SamuelLost/sbesc-esc-2024/README.md

# Boia para Monitoramento e Prevenção de Inundações - ESC 2024
