SamuelLost/sbesc-esc-2024/imgs/sbesc-water-level-v2.png

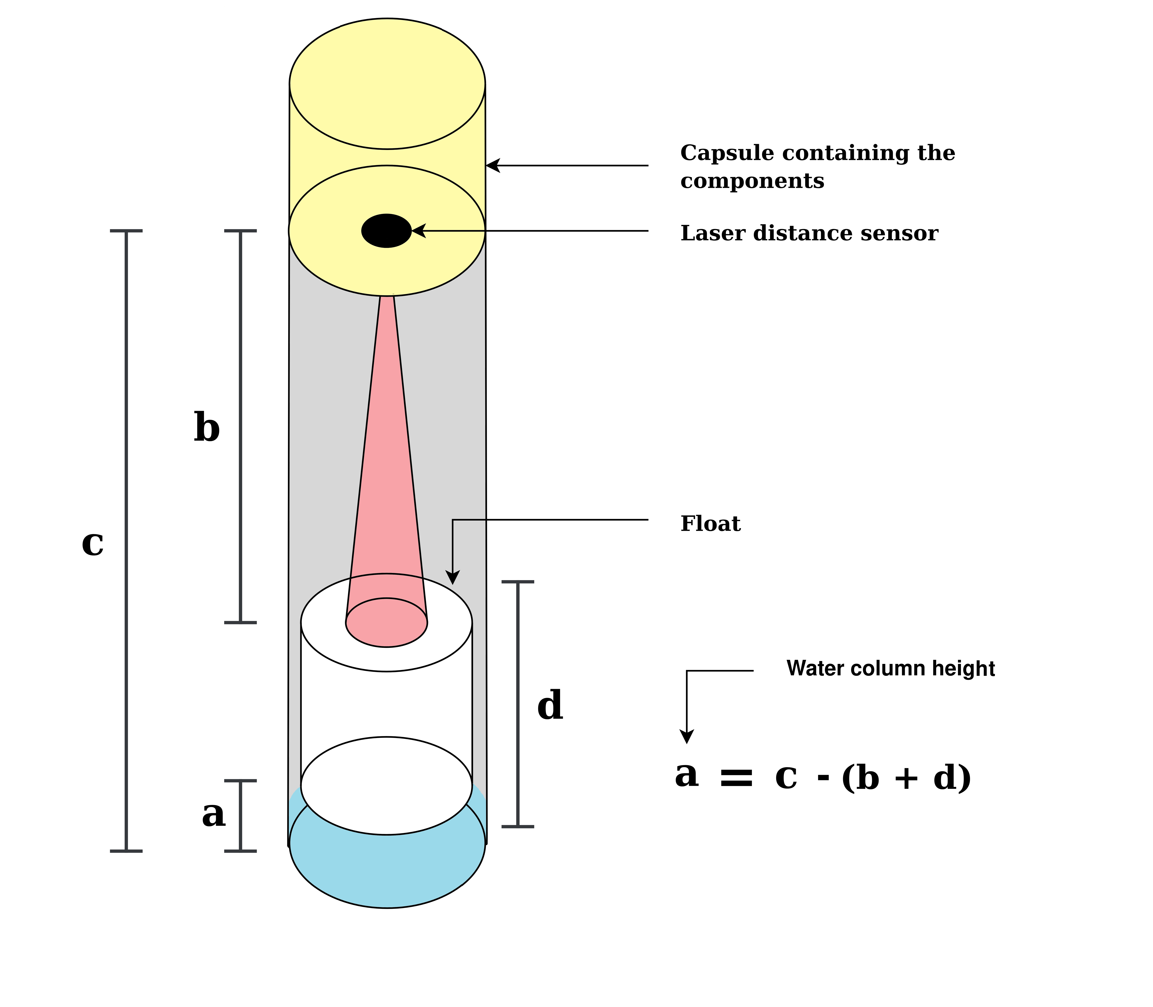
imgs/sbesc-water-level-v2.png
