SamuelLost/sbesc-esc-2024/imgs/sbesc-water-level.png

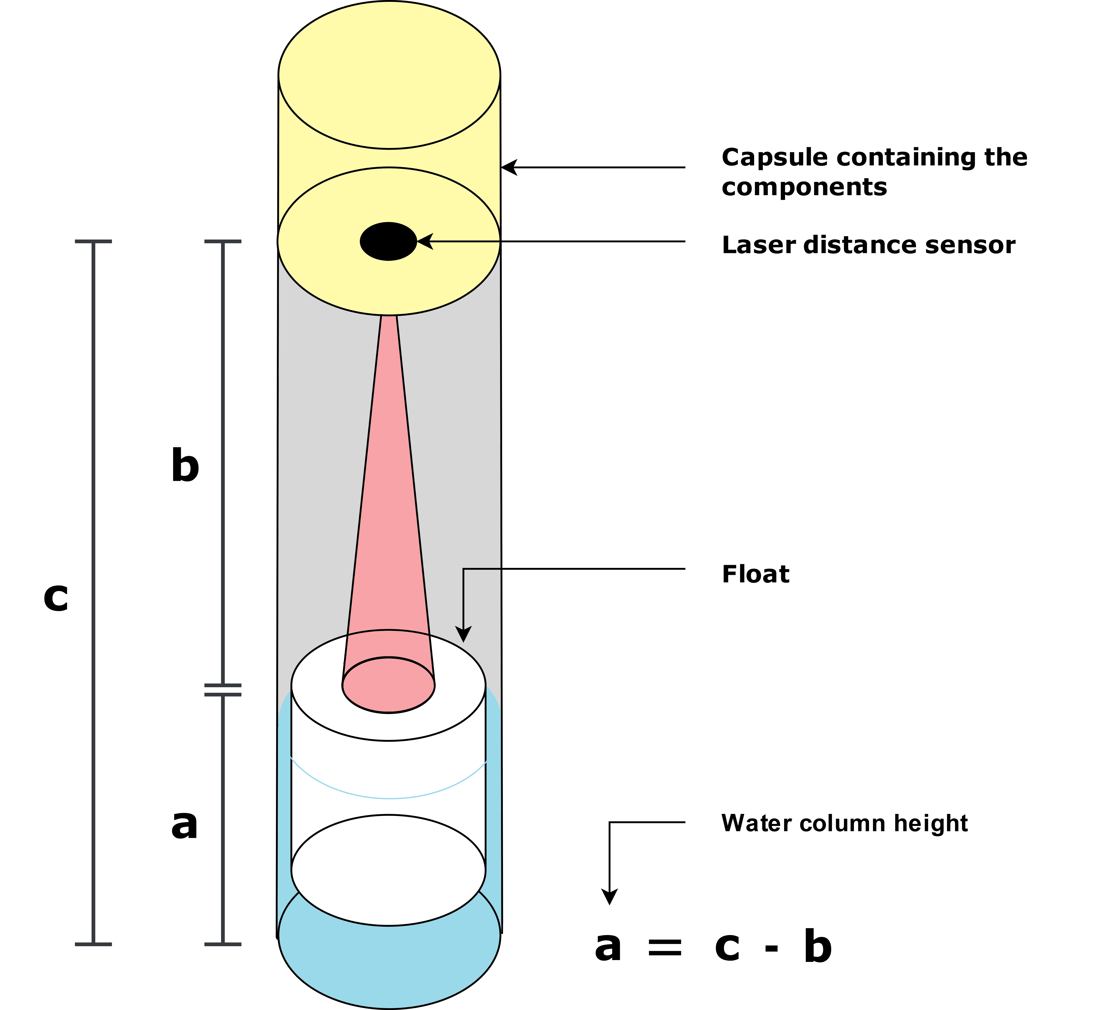
imgs/sbesc-water-level.png
