SamuelLost/sbesc-esc-2024/(list of files, drawings)

Other design files:
docs/fritzing/circuito_prototipo.fzz
docs/fritzing/circuito_prototipo_powerbank.fzz
docs/fritzing/node_receiver.fzz
