SamuelLost/sbesc-esc-2024/firmware/components/accelerometer_sensor/include/mpu6050.h

#ifndef _ACCELEROMETER_SENSOR_H_
#define _ACCELEROMETER_SENSOR_H_

#include <stdint.h>
#include <stdbool.h>
#include "esp_err.h"
#include "driver/i2c.h"
#include "i2c_driver.h"
#include "mpu6050_registers.h"


#ifdef __cplusplus
extern "C" {
#endif

typedef union {
    int16_t raw;
    float converted;
} accel_axis_t;

// Accelerometer sensor data structure
typedef struct {
    accel_axis_t accel_x;
    accel_axis_t accel_y;
    accel_axis_t accel_z;
} acceleration_data_t;

typedef union {
    int16_t raw;
    float converted;
} gyro_axis_t;
// Gyroscope sensor data structure
typedef struct {
    gyro_axis_t gyro_x;
    gyro_axis_t gyro_y;
    gyro_axis_t gyro_z;
} gyroscope_data_t;

typedef enum {
    A2G, // +/- 2g
    A4G, // +/- 4g
    A8G, // +/- 8g
    A16G // +/- 16g
} accel_range_t;

typedef enum {
    G250DPS, // +/- 250 degrees per second
    G500DPS, // +/- 500 degrees per second
    G1000DPS, // +/- 1000 degrees per second
    G2000DPS // +/- 2000 degrees per second
} gyro_range_t;

typedef enum {
    ACCEL_RAW, // raw data
    ACCEL_MPS2, // meters per second squared
    ACCEL_G, // g-force
    GYRO_RAW, // raw data
    GYRO_DPS // degrees per second
} unit_measurement_t;

typedef struct {
    float pitch;
    float roll;
} angle_pair_t;

typedef struct {
    angle_pair_t gyro;
    angle_pair_t accel;
    angle_pair_t complementary_filter;
} angles_data_t;

// MPU6050 configuration structure
typedef struct {
    i2c_t i2c;
    uint8_t addr;
    accel_range_t accel_range;
    gyro_range_t gyro_range;
} mpu6050_t;

/**
 * @brief Initialize the MPU6050 sensor
 * 
 * @param config mpu6050_t configuration structure
 * @return bool 
 */
bool mpu6050_init(mpu6050_t *config);

/**
 * @brief Deinitialize the MPU6050 sensor
 * 
 * @param config mpu6050_t configuration structure
 */
void mpu6050_deinit(mpu6050_t *config);

/**
 * @brief Check if the MPU6050 sensor is alive
 * 
 * @param config mpu6050_t configuration structure
 * @return bool 
 */
bool mpu6050_is_alive(mpu6050_t *config);

/**
 * @brief Get the acceleration data
 * 
 * @param accel_data
 * @return bool 
 */
bool mpu6050_get_acceleration(mpu6050_t *config, acceleration_data_t *accel_data, unit_measurement_t unit);

/**
 * @brief Get the gyroscope data
 * 
 * @param gyro_data 
 * @return bool 
 */
bool mpu6050_get_gyroscope(mpu6050_t *config, gyroscope_data_t *gyro_data, unit_measurement_t unit);

/**
 * @brief Get the angles data
 * 
 * @param config mpu6050_t configuration structure
 * @param angles_data angles_data_t structure to store the angles data
 * @param delta_time Time interval between measurements. If negative, the function will not use the gyroscope data
 *          to calculate the angles. If positive, the function will use the complementary filter to calculate the angles.
 *          Is recommended to use a value between 0.01 and 0.1.
 * @return bool 
 */
bool mpu6050_get_angles(mpu6050_t *config, angles_data_t *angles_data, float delta_time);

#ifdef __cplusplus
}
#endif

#endif // _ACCELEROMETER_SENSOR_H_
