SamuelLost/sbesc-esc-2024/(commit log)

2024-09-02 feat: add i2c_driver interface
    This component will abstract all I2C transactions
2024-09-02 feat: add accelerometer_sensor component
    Define interfaces for managing the MPU6050 accelerometer
2024-09-02 fix: change return types, fix structs and add I2C functions
    [i2c_driver.h, mpu6050.c, mpu6050.h, mpu6050_registers.h]
2024-09-02 feat: add temperature_sensor component
    Define interfaces for managing the SHT30 temperature sensor
2024-09-02 feat: add interfaces for UART and LoRa module
    1) Implement UART driver to send AT commands to the LoRa module.
    2) Create lora_module component to manage LoRa communication.
2024-09-02 feat: add interfaces for ADC and IR sensor
    1) Implement ADC driver
    2) Create ir_sensor component to manage reads from infrared sensor
2024-10-19 feat: add driver for accelerometer MPU6050
    1) Implement the functions of i2c_driver and accelerometer_sensor components
    2) Add a vTaskAccelerometer that reads the acceleration
    3) Add the component utils for macros and other useful functions
2024-10-19 feat: add more validation and guardrail
    1) Add macro RESTART
    2) Add validation in i2c_driver component
2024-10-19 feat: add UART driver
2024-10-19 feat: refactor LoRa module to use lora_packet_t and improve code clarity
    1) Updated `lora_module_send` and `lora_module_receive` to accept `lora_packet_t` instead of separate data and size parameters.
    2) Moved `lora_packet_t` definition to the header file and corrected bandwidth constants to include units (`BANDWIDTH_250KHZ`, `BANDWIDTH_500KHZ`).
    [lora_module.c, lora_module.h]
2024-10-19 feat: add UART config for tests with UART 1
2024-10-19 feat: add support for sending application data via LoRa module
    Successfully established and tested communication between two devices.
    1. Added CMD_APPLICATION command to the lora_cmd_t enum to support application data transmission.
    2. Introduced device_id field in the lora_module_t struct to specify the device ID.
    3. Implemented prepare_lora_packet function to prepare and send LoRa packets with application data.
    4. Renamed _prepare_packet to _prepare_packet_command for improved clarity.
    5. Fixed byte order in UID calculation within the _read_local_device_info function.
    6. Implemented _set_network_id function to configure the device's network ID.
    7. Updated main.c to send a test message "Hel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
    [lora_module.c, lora_module.h, main.c, receiver.c]
2024-10-19 chore: update LoRa module and device info handling
    1. Added new channel field in local device info structure.
    2. Removed redundant function parameters from internal LoRa configuration functions.
    3. Updated device information printout to reflect the new structure changes.
    4. Adjusted default device ID in receiver logic from 254 to 1.
2024-10-19 feat: add implementation of laser_sensor component
    1) Get distance in millimeters
    2) Set passive mode, read distance only after send command
    3) Clear the data with strtok
    4) Add uart_read_timeout function in uart_driver
2024-10-19 feat: add interfaces and enums to SHT30 driver
2024-10-19 fix: I2C driver to support multi-bytes i2c_write and i2c_read
    [i2c_driver.c, i2c_driver.h, mpu6050.c, sht30.c]
2024-10-19 fix: i2c_driver component
    1) Add i2c_write_read function
    2) Add i2c_read function
    3) Add enum i2c_freq_t to select frequency
    [i2c_driver.c, i2c_driver.h, mpu6050.c]
2024-10-19 feat: implement temperature_sensor component
    1) Get temperature and humidity
    2) Only single shot mode
    3) Use 100KHZ I2C frequency
    4) Integrated on main.c file
2024-10-19 feat: improve applications main.c and receiver.c
    1) Add tasks handlers
    2) Add multi-core
    3) Add switch statement to receiver
    4) Add HeartBeat task
    5) Fix len of prepare_lora_packet
    [lora_module.c, main.c, receiver.c]
2024-10-29 feat: add MQTT driver
    Send messages to topics of mosquitto broker
    [receiver.c]
2024-10-29 feat: communication with MQTT broker works
    1) Refactor Wi-Fi driver
    2) Refactor MQTT driver
    3) Change %d to %hu for distance values
    4) Add null-terminator on message reiceived
    5) Improve logic to snprintf and mqtt_publish
    [main.c, receiver.c]
2024-10-29 feat: add credentials do broker and length of pipe
    [receiver.c]
2024-11-06 feat: get roll and pitch angles from acceleration
2024-11-06 feat: implement heartbeat task and publish pitch and roll angles
2024-11-22 feat: add mutex for sensors structures
2024-11-22 feat: add fritzing circuits, final report, images and update flow node-red
    [circuito_prototipo.fzz, circuito_prototipo_powerbank.fzz, node_receiver.fzz]
